madaari/SemiconductorCurveTracer/README.md

# SemiconductorCurveTracer
All the data related to Semiconductor Curve Tracer.

This Repo contains the design files, code files of every version of curve tracer
build at TI-CEPD.
