madaari/SemiconductorCurveTracer/design_files/routed_board.png

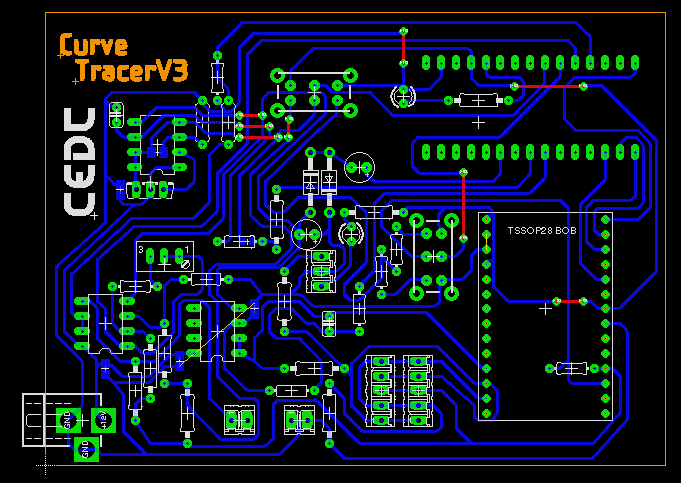
design_files/routed_board.png
