madaari/SemiconductorCurveTracer/design_files/schematic.png

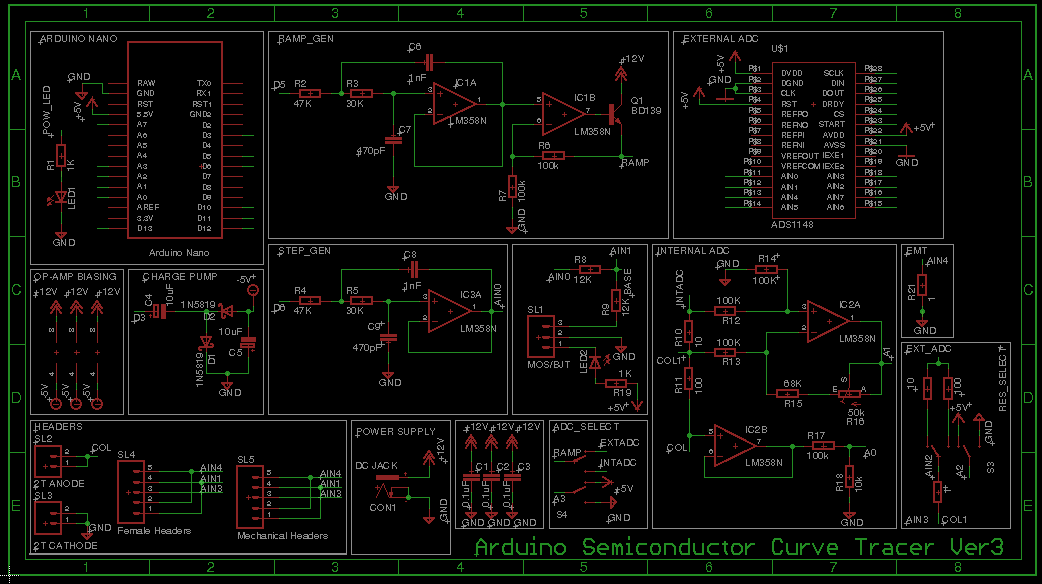
design_files/schematic.png
