madaari/SemiconductorCurveTracer/design_files/ArduinoCurveTracer3_V1.brd

## EAGLE design design_files/ArduinoCurveTracer3_V1.brd (2019-12-09)

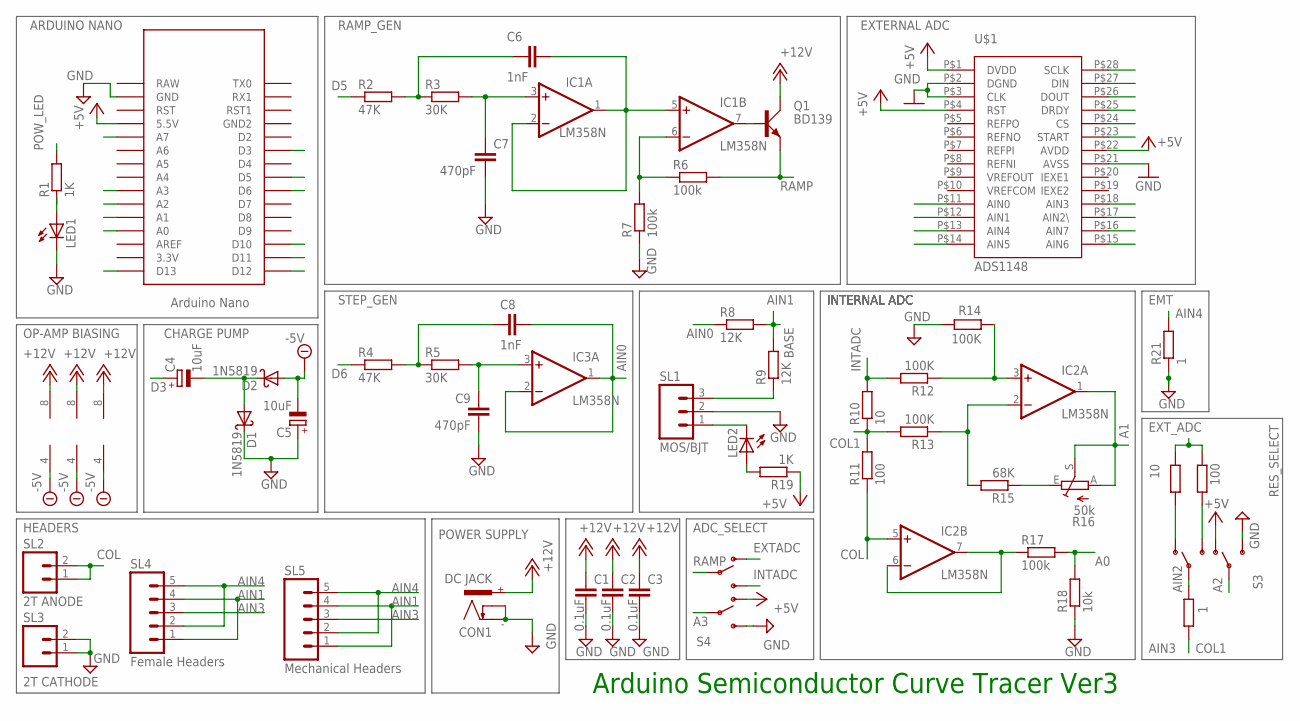
[picture p5: schematic ArduinoCurveTracer3_V1.sch]

Parts:
ARDUINONANO: NANO
C1, C2, C3: 0.1uF; C0805
C4, C5: 10uF; E2,5-5
C6: 1nF; C0603
C7: 470pF; C025-024X044
C8: 1nF; C025-024X044
C9: 470pF; C0805
CON1: DC JACK; NEB21R
D1, D2: 1N5819; DO41-10
IC1, IC2, IC3: LM358N; DIL08
LED1, LED2: LED3MM
Q1: BD139; TO126AV
R1, R19: 1K; 0207/10
R2: 47K; 0207/10
R3, R5: 30K; 0204/7
R4: 47K; 0204/7
R6: 100k; M0805
R7, R17: 100k; 0207/7
R8, R9: 12K; 0207/10
R10: 10; 0207/10
R11: 100; 0207/10
R12, R13: 100K; 0207/10
R14: 100K; 0204/7
R15: 68K; 0204/7
R16: 50k; S64W
R18: 10k; 0204/7
R21: 1; 0207/10
R22: 10; 0204/7
R23: 100; 0204/7
R24: 1; 0204/7
S3, S4: SWITCH-SPDTPTH2; SWITCHE-DPDT
SL1: MOS/BJT; 03P
SL2: 2T ANODE; 02P
SL3: 2T CATHODE; 02P
SL4: Female Headers; 05P
SL5: Mechanical Headers; 05P
U$1: ADS1148; TSSOP-28

Connections:
+5V: ARDUINONANO.5V (5.5V), R19.1, S3.4, S4.4, U$1.P$1 (DVDD), U$1.P$4 (RST), U$1.P$22 (AVDD)
+12V: C1.1, C2.1, C3.1, CON1.+, IC1.8 (V+), IC2.8 (V+), IC3.8 (V+), Q1.C
-5V: C5.-, D2.A, IC1.4 (V-), IC2.4 (V-), IC3.4 (V-)
A0: ARDUINONANO.A0, R17.2, R18.2
A1: ARDUINONANO.A1, IC2.1 (OUT), R16.A, R16.S
A2: ARDUINONANO.A2, S3.5
A3: ARDUINONANO.A3, S4.5
AIN0: C8.2, IC3.1 (OUT), IC3.2 (-IN), R8.1, U$1.P$11 (AIN0)
AIN1: R8.2, R9.2, SL4.1, SL4.4, SL5.1, SL5.4, U$1.P$12 (AIN1)
AIN2: R24.1, S3.2, U$1.P$17 (AIN2\)
AIN3: R10.1, R11.2, R13.2, R24.2, SL4.3, SL5.3, U$1.P$18 (AIN3)
AIN4: R21.2, SL4.2, SL4.5, SL5.2, SL5.5, U$1.P$13 (AIN4)
AIN5: U$1.P$14 (AIN5)
AIN6: U$1.P$15 (AIN6)
AIN7: U$1.P$16 (AIN7)
COL: IC2.5 (+IN), R11.1, SL2.1, SL2.2
CS: ARDUINONANO.D10, U$1.P$24 (CS)
D3: ARDUINONANO.D3, C4.+
D5: ARDUINONANO.D5, R2.1
D6: ARDUINONANO.D6, R4.1
DIN: ARDUINONANO.D11, U$1.P$27 (DIN)
DOUT: ARDUINONANO.D12, U$1.P$26 (DOUT)
DRDY: U$1.P$25 (DRDY)
EXTADC: R22.2, R23.2, S4.1
GND: ARDUINONANO.GND, C1.2, C2.2, C3.2, C5.+, C7.2, C9.1, CON1.-, CON1.C, D1.C, LED1.K (C), R7.1, R14.1, R18.1, R21.1, S3.6, S4.6, SL1.2, SL3.1, SL3.2, U$1.P$2 (DGND), U$1.P$3 (CLK), U$1.P$21 (AVSS)
INTADC: R10.2, R12.2, S4.3
unnamed: C4.-, D1.A, D2.C
unnamed: R9.1, SL1.3
unnamed: C6.1, R2.2, R3.1
unnamed: C7.1, IC1.3 (+IN), R3.2
unnamed: IC1.7 (OUT), Q1.B
unnamed: LED2.K (C), SL1.1
unnamed: IC1.6 (-IN), R6.1, R7.2
unnamed: C8.1, R4.2, R5.1
unnamed: C9.2, IC3.3 (+IN), R5.2
unnamed: LED2.A, R19.2
unnamed: R22.1, S3.1
unnamed: IC2.3 (+IN), R12.1, R14.2
unnamed: IC2.2 (-IN), R13.1, R15.2
unnamed: IC2.6 (-IN), IC2.7 (OUT), R17.1
unnamed: R15.1, R16.E
unnamed: LED1.A, R1.1
unnamed: R23.1, S3.3
POW_LED: ARDUINONANO.A7, R1.2
RAMP: C6.2, IC1.1 (OUT), IC1.2 (-IN), IC1.5 (+IN), Q1.E, R6.2, S4.2
SCLK: ARDUINONANO.D13, U$1.P$28 (SCLK)
START: U$1.P$23 (START)

Notes on the sheet:
Arduino Semiconductor Curve Tracer Ver3
EMT
POWER SUPPLY
CHARGE PUMP
OP-AMP BIASING
COL1
BASE
RES_SELECT
INTADC
ADC_SELECT
HEADERS
AIN2
AIN3
AIN1
RAMP_GEN
STEP_GEN
EXT_ADC
AIN4
RAMP
EXTADC
EXTERNAL ADC
POW_LED
ARDUINO NANO
INTERNAL ADC

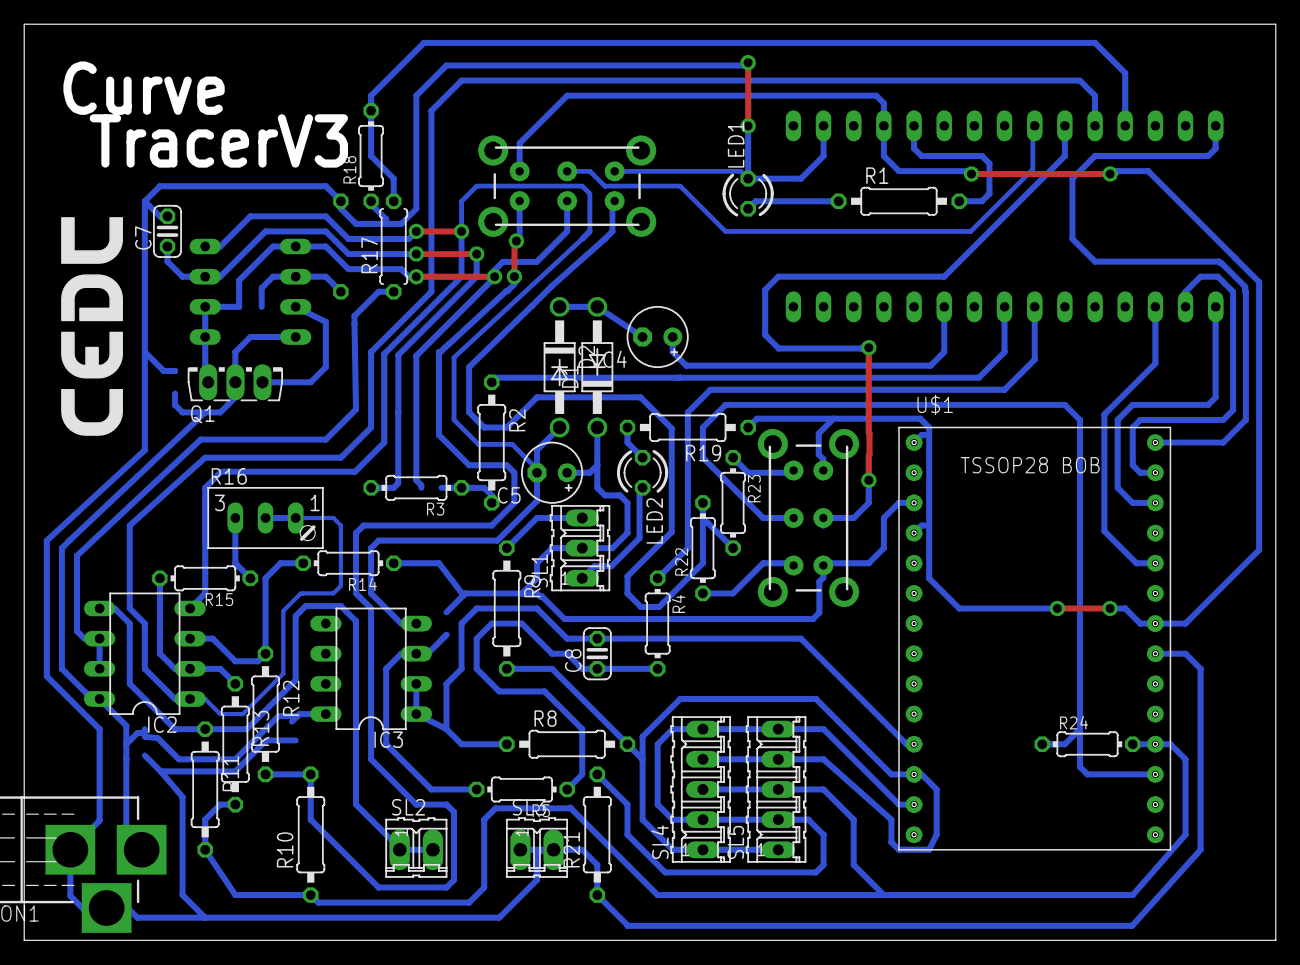
[picture p6: board ArduinoCurveTracer3_V1.brd from above]

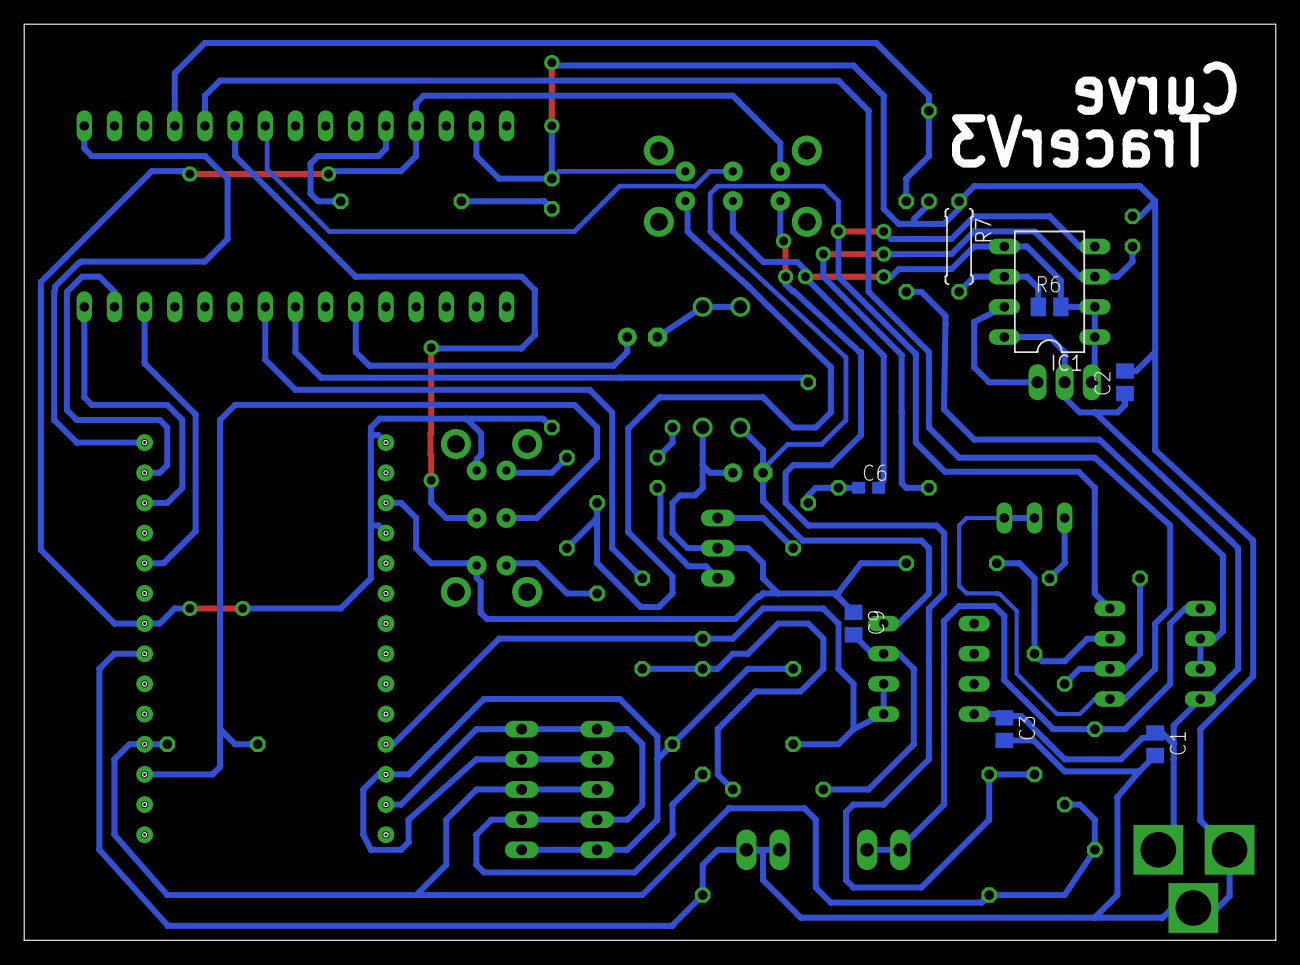
[picture p7: board ArduinoCurveTracer3_V1.brd from below]

Board: 2 copper layers, 105.4 x 77.1 mm, 51 parts (8 on the bottom side), 42 nets.

Other parts of the board:
U$2: LOGO-CEDT-SILK-18MM
