madaari/SemiconductorCurveTracer/GUI/pyinstaller_files/build/images/beta.jpg

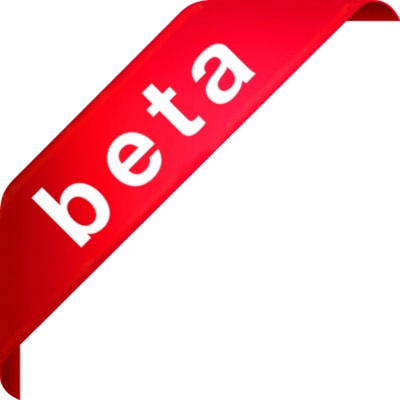
GUI/pyinstaller_files/build/images/beta.jpg
