madaari/SemiconductorCurveTracer/GUI/pyinstaller_files/build/images/bjt.jpg

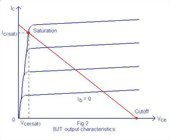
GUI/pyinstaller_files/build/images/bjt.jpg
