madaari/SemiconductorCurveTracer/GUI/pyinstaller_files/build/images/diode.jpg

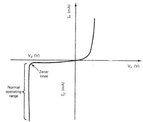
GUI/pyinstaller_files/build/images/diode.jpg
