madaari/SemiconductorCurveTracer/docs/results/BD139.png

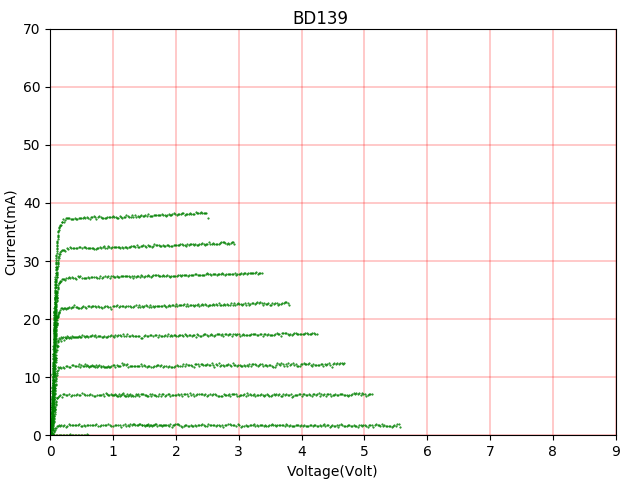
docs/results/BD139.png
