madaari/SemiconductorCurveTracer/docs/results/PN2222A_1.png

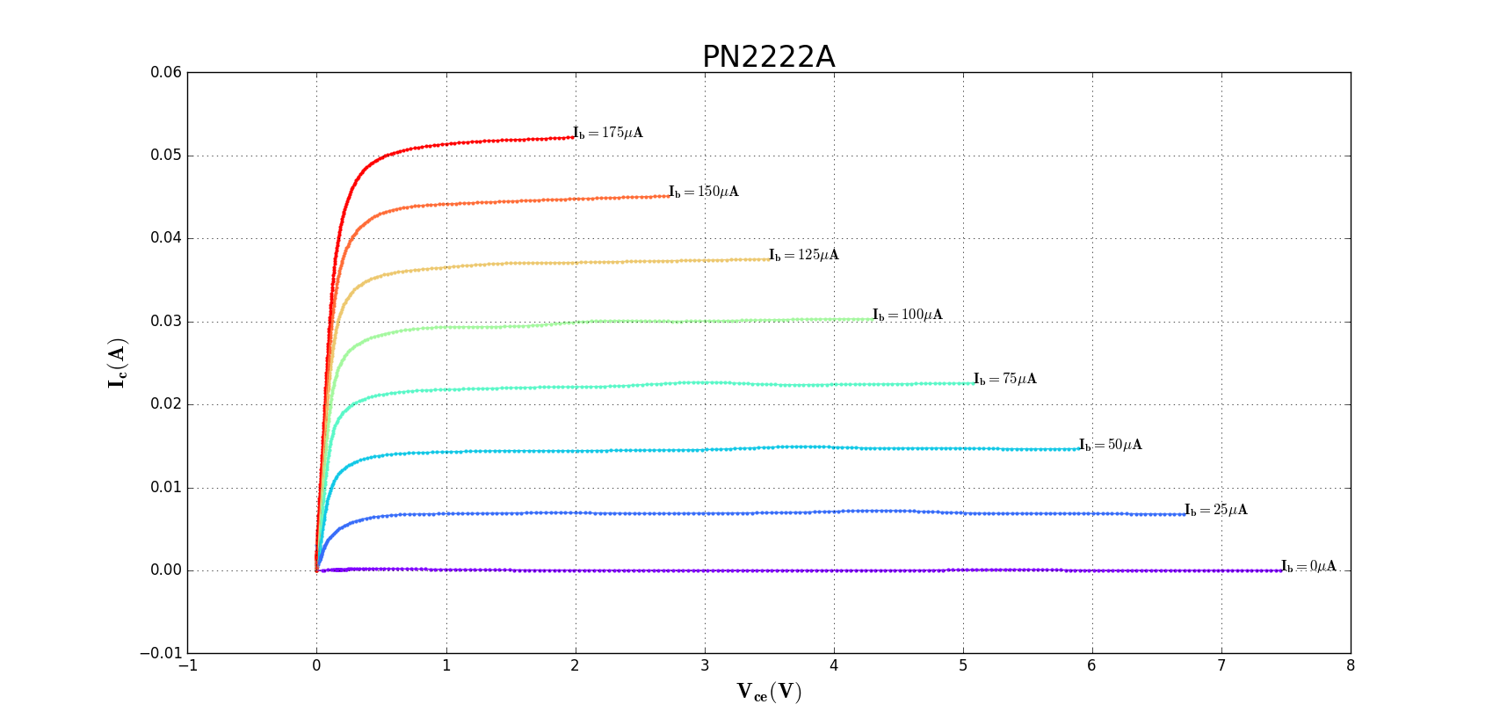
docs/results/PN2222A_1.png
