madaari/SemiconductorCurveTracer/docs/results/RED_LED.png

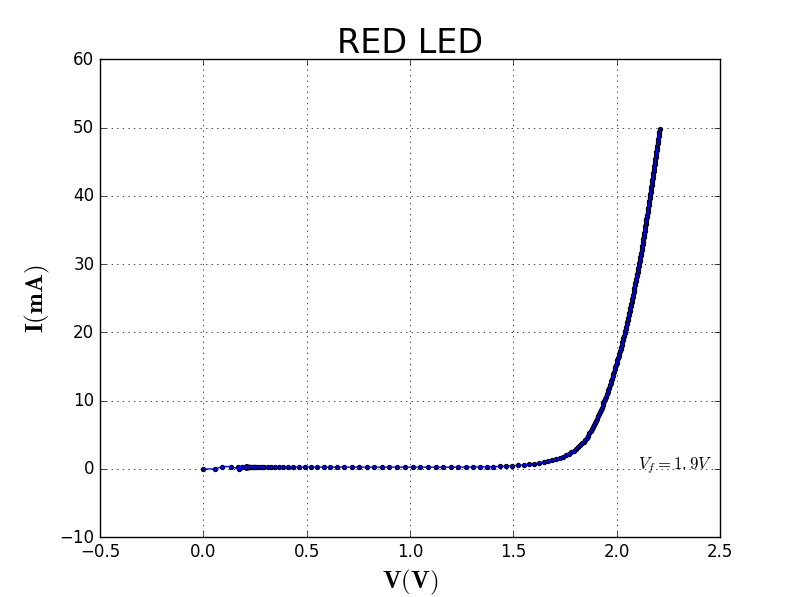
docs/results/RED_LED.png
